awsomechicken/NetworkedKettle/README.md

# NetworkedKettle
This Project is to modify a _specific_ Electric kettle to connect it to a raspberry pi and reduce the tedium of waiting for warm water.

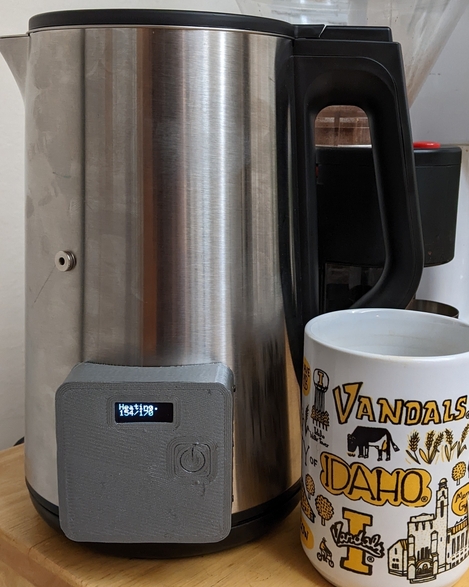
[picture p1: Hardware/img/Assembled.jpg]
project picture
