awsomechicken/NetworkedKettle/Software/README.MD

# Software Folder
Here will be the Node-RED flows you can import and run
There will also be a setup guide for the supporting software.

## Software Dependencies:
1. Node-RED:
    - Aedes Broker Node: `node-red-contrib-aedes`
    - Dashboard : `node-red-dashboard`
2. HAProxy: Used to translate the Node-RED 1880/ui to port 80 (optional)
3. WiFi AP : hostapd
4. DNS Service: dnsmasq

Items 3 and 4 can be installed using the guide from [learn.sparkfun.com](https://learn.sparkfun.com/tutorials/setting-up-a-raspberry-pi-3-as-an-access-point/all)

## To Do
- [x] Publish the Software
- [x] Fix Human Detector
- [ ] Software Dependencies
- [ ] Use Scheduling
