awsomechicken/NetworkedKettle/Hardware/img/Base_inside.jpg

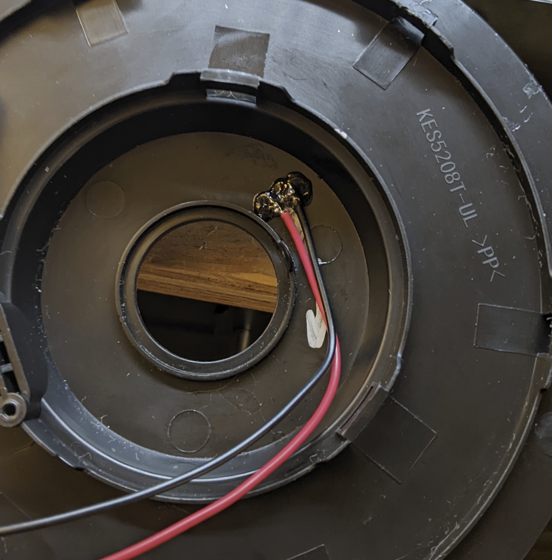
Hardware/img/Base_inside.jpg
