awsomechicken/NetworkedKettle/Hardware/img/BoardNormal.jpg

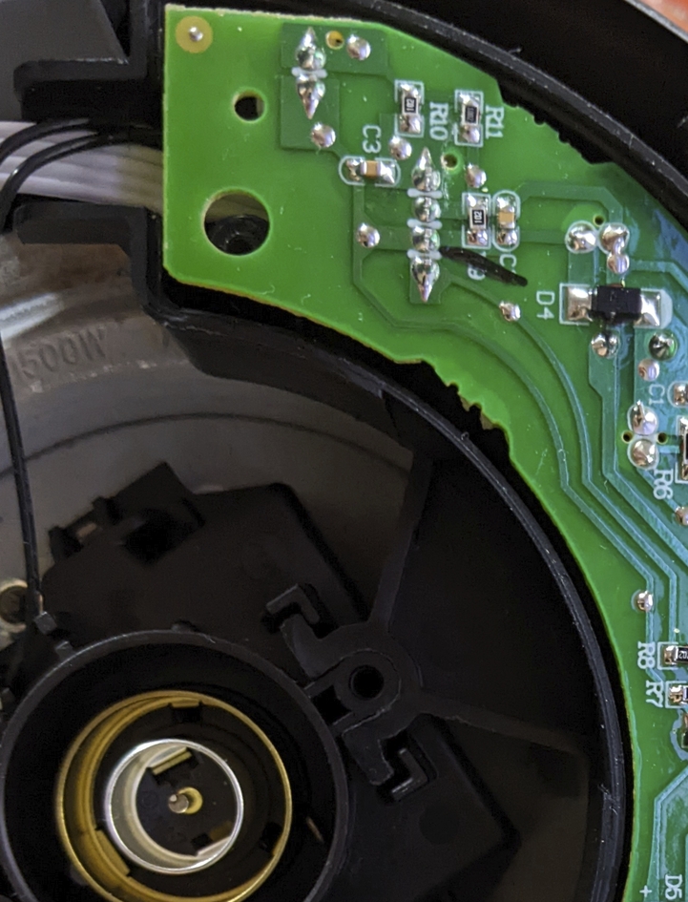
Hardware/img/BoardNormal.jpg
