awsomechicken/NetworkedKettle/Hardware/KettleController/3D_Models/control_box_display_hole.stl

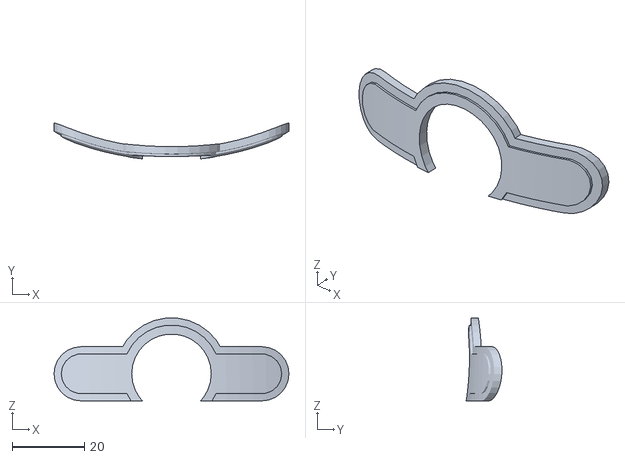
[picture p7: CAD file, 2022-05-03]
Hardware/KettleController/3D_Models/control_box_display_hole.stl
65.0 x 9.92 x 22.9
