awsomechicken/NetworkedKettle/Hardware/KettleController/The_Ring_of_Power/mfg_files/The_Ring_of_Power-Edge_Cuts.dxf

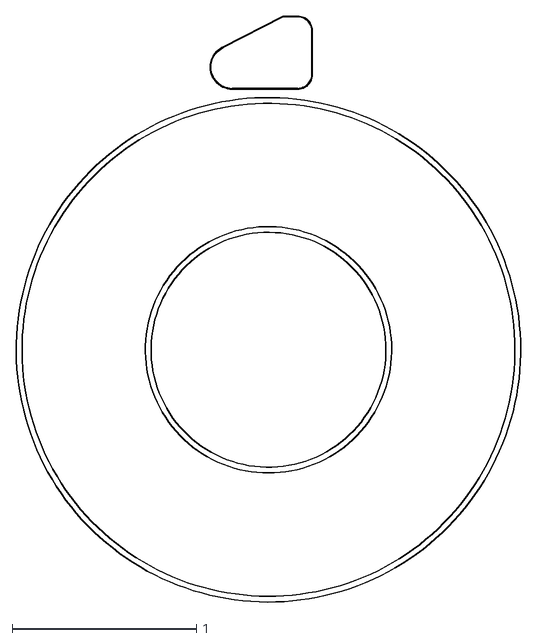
[picture p8: CAD file, 2022-05-03]
Hardware/KettleController/The_Ring_of_Power/mfg_files/The_Ring_of_Power-Edge_Cuts.dxf
2.74 x 3.18
