awsomechicken/NetworkedKettle/Hardware/KettleController/3D_Models/control_box_wemos_clip.stl

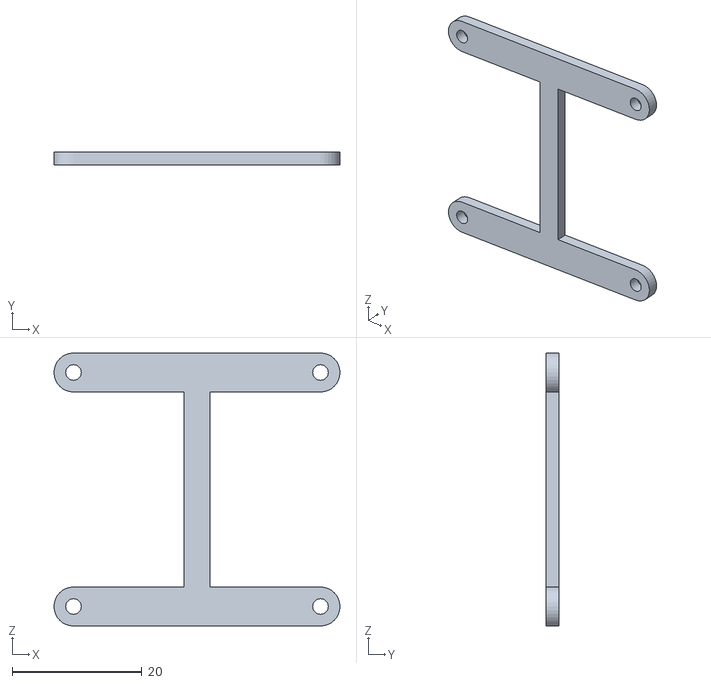
[picture p9: CAD file, 2022-05-03]
Hardware/KettleController/3D_Models/control_box_wemos_clip.stl
44.0 x 2.00 x 42.0
