awsomechicken/NetworkedKettle/Hardware/KettleController/3D_Models/control_box_ring_of_power.stl

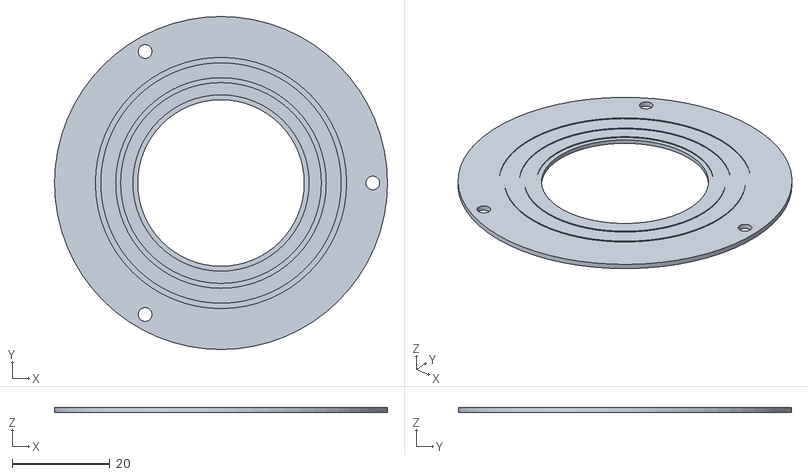
[picture p10: CAD file, 2022-05-03]
Hardware/KettleController/3D_Models/control_box_ring_of_power.stl
68.0 x 68.0 x 1.00
