awsomechicken/NetworkedKettle/Hardware/KettleController/3D_Models/control_box_kettle_wire_clamp.stl

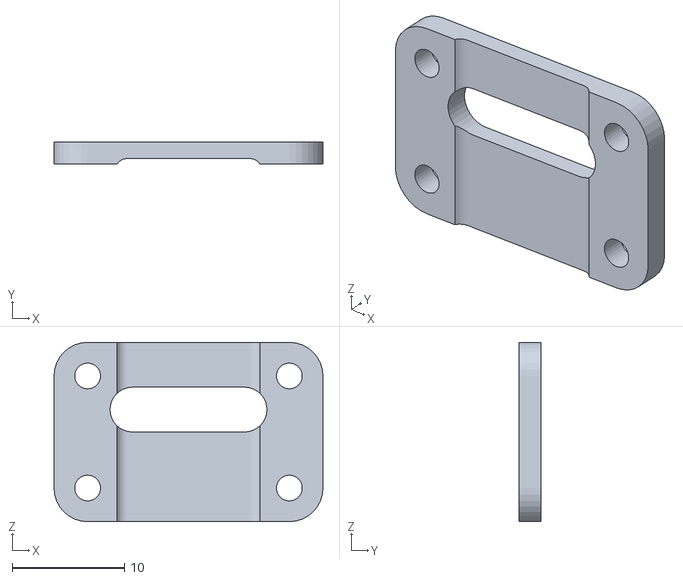
[picture p11: CAD file, 2022-05-03]
Hardware/KettleController/3D_Models/control_box_kettle_wire_clamp.stl
24.0 x 2.00 x 16.0
