awsomechicken/NetworkedKettle/Hardware/KettleController/3D_Models/control_box_kettle_hole.stl

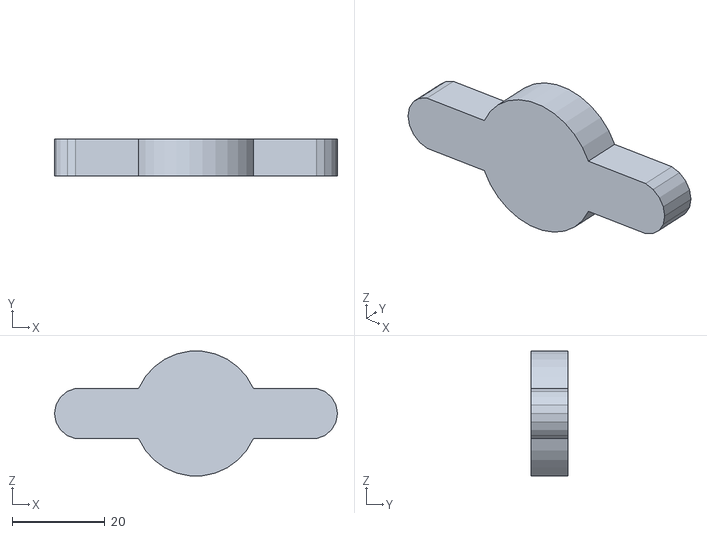
[picture p12: CAD file, 2022-05-03]
Hardware/KettleController/3D_Models/control_box_kettle_hole.stl
61.0 x 8.00 x 26.9
