awsomechicken/NetworkedKettle/Hardware/KettleController/3D_Models/control_box.stl

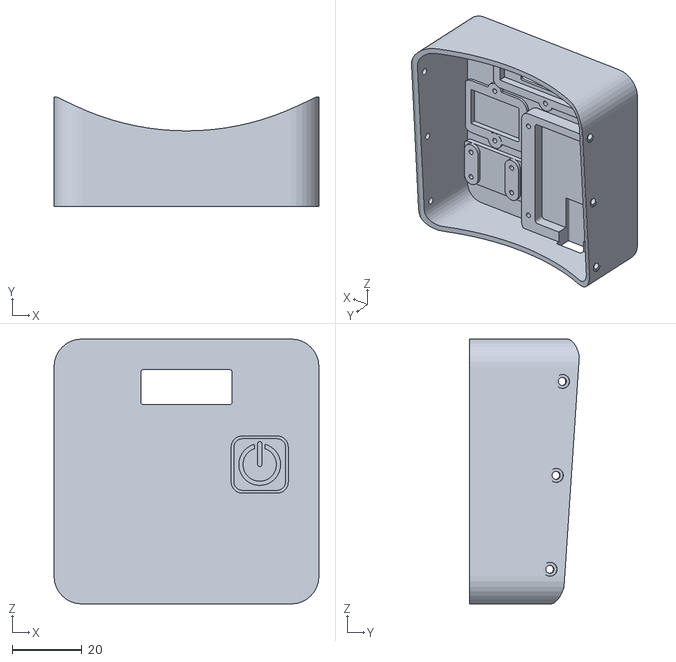
[picture p13: CAD file, 2022-05-03]
Hardware/KettleController/3D_Models/control_box.stl
76.0 x 31.4 x 76.0
