awsomechicken/NetworkedKettle/Hardware/KettleController/3D_Models/control_box_outer_plate.stl

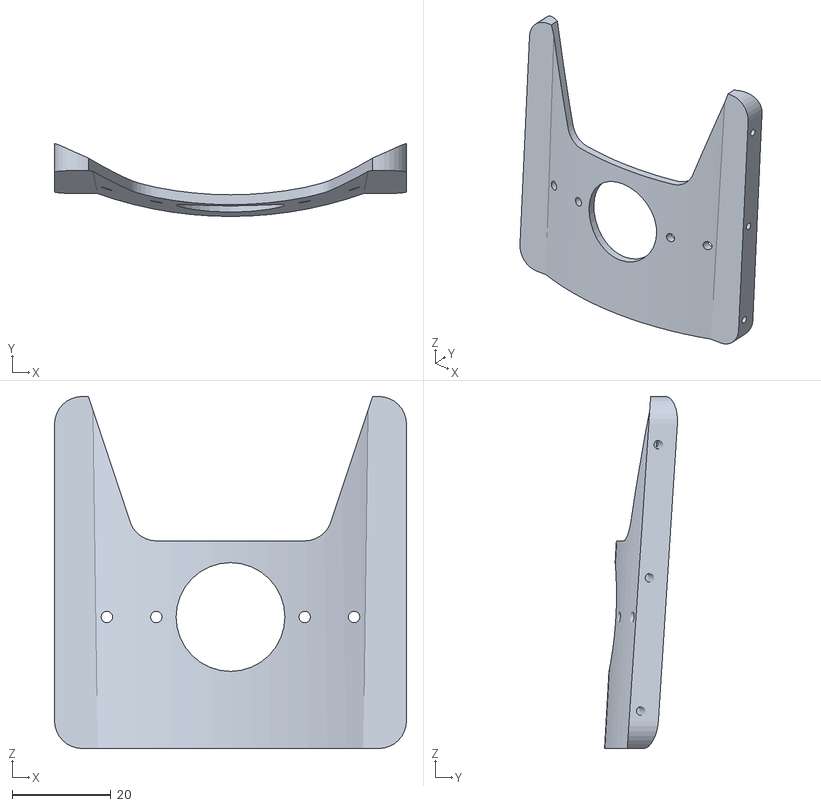
[picture p14: CAD file, 2022-05-03]
Hardware/KettleController/3D_Models/control_box_outer_plate.stl
71.2 x 14.8 x 71.2
