awsomechicken/NetworkedKettle/Hardware/KettleController/3D_Models/control_box_inner_plate.stl

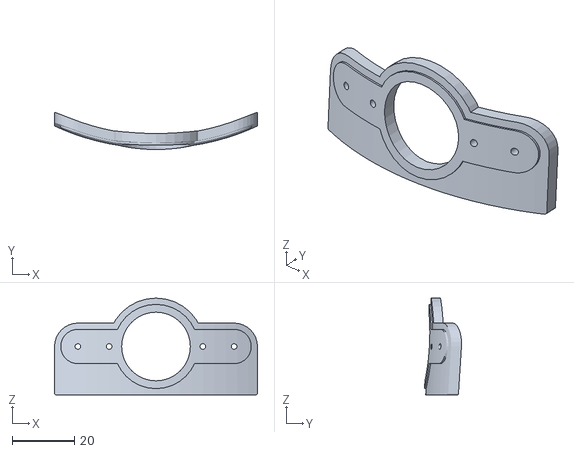
[picture p15: CAD file, 2022-05-03]
Hardware/KettleController/3D_Models/control_box_inner_plate.stl
65.0 x 11.9 x 31.0
