awsomechicken/NetworkedKettle/Hardware/KettleController/3D_Models/control_box_drill_template.stl

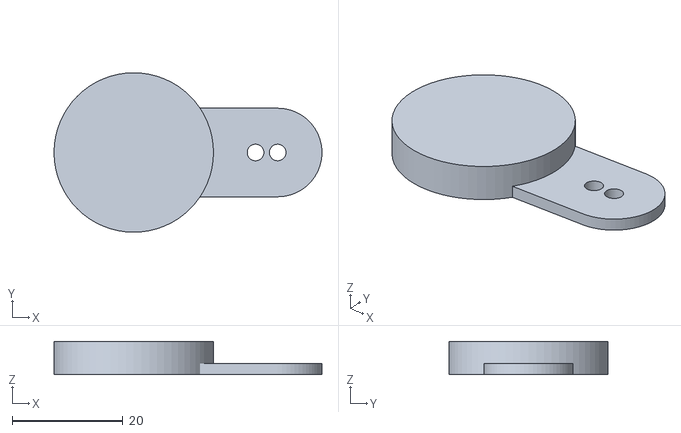
[picture p16: CAD file, 2022-05-03]
Hardware/KettleController/3D_Models/control_box_drill_template.stl
48.4 x 28.8 x 6.00
