awsomechicken/NetworkedKettle/Hardware/KettleController/Controller_Schematic.pdf

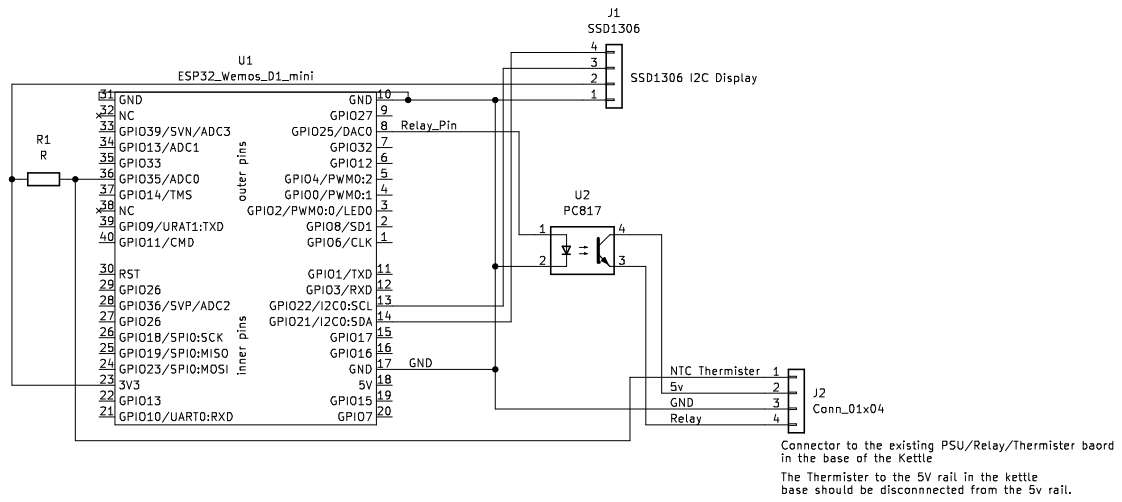
[picture p17: page 1]
