awsomechicken/NetworkedKettle/(commit log)

2022-05-03 Put Files in their place.
    [The_Ring_of_Power-Edge_Cuts.dxf, The_Ring_of_Power.kicad_pcb, The_Ring_of_Power.kicad_sch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]
2022-05-05 Added Flows to the Software Folder
2022-05-05 Updated the hardware BOM
    [control_box.scad, control_box.stl, control_box_display_hole.stl, control_box_drill_template.stl, control_box_inner_plate.stl, control_box_kettle_hole.stl, control_box_kettle_wire_clamp.stl, control_box_outer_plate.stl]
2022-05-05 Added Controller Schematic
    [Controller_Schematic.kicad_pcb, Controller_Schematic.kicad_sch]
2022-05-05 Extended BOM, Added pictures
2022-05-05 adjusted the BOM
2022-05-06 Added more content
    [Controller_Schematic.kicad_pcb, Controller_Schematic.kicad_sch]
